rohitnagvenkar/UnmannedVehicleSystems/UVS_images/image016.gif

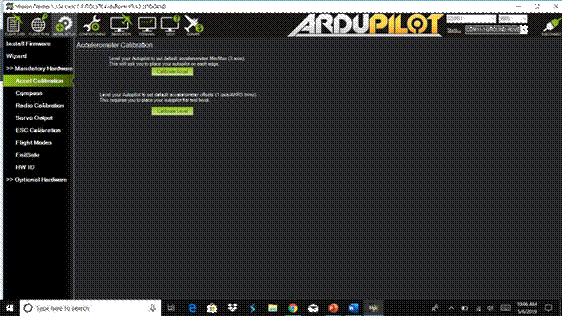
UVS_images/image016.gif
