rohitnagvenkar/UnmannedVehicleSystems/UVS_images/image029.gif

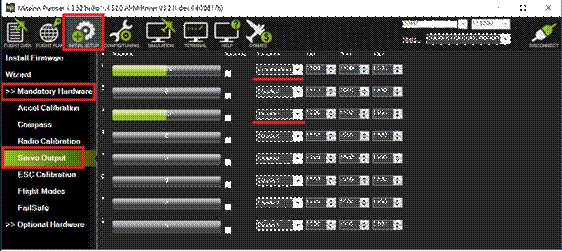
UVS_images/image029.gif
