rohitnagvenkar/UnmannedVehicleSystems/UVS_images/image031.jpg

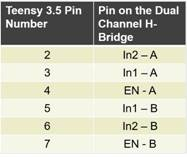
UVS_images/image031.jpg
