rohitnagvenkar/UnmannedVehicleSystems/UVS_images/image048.jpg

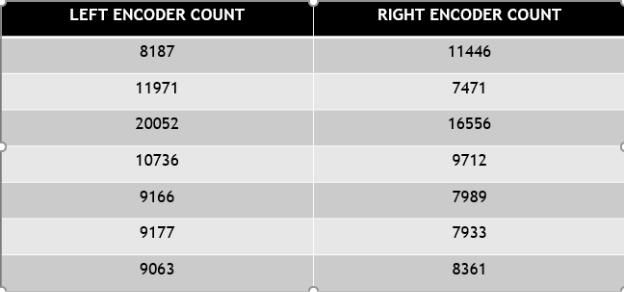
UVS_images/image048.jpg
