rohitnagvenkar/UnmannedVehicleSystems/UVS_images/image049.gif

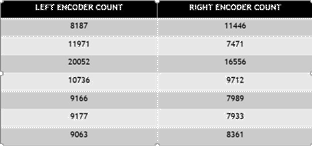
UVS_images/image049.gif
