rohitnagvenkar/UnmannedVehicleSystems/UVS_images/image052.jpg

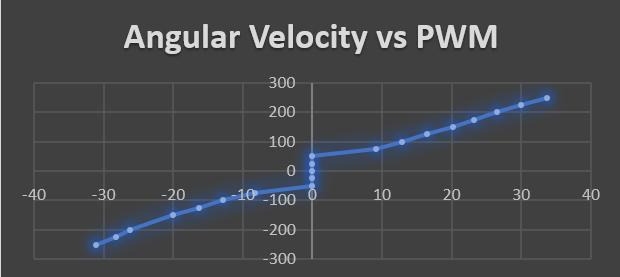
UVS_images/image052.jpg
