rohitnagvenkar/UnmannedVehicleSystems/UVS_images/image072.jpg

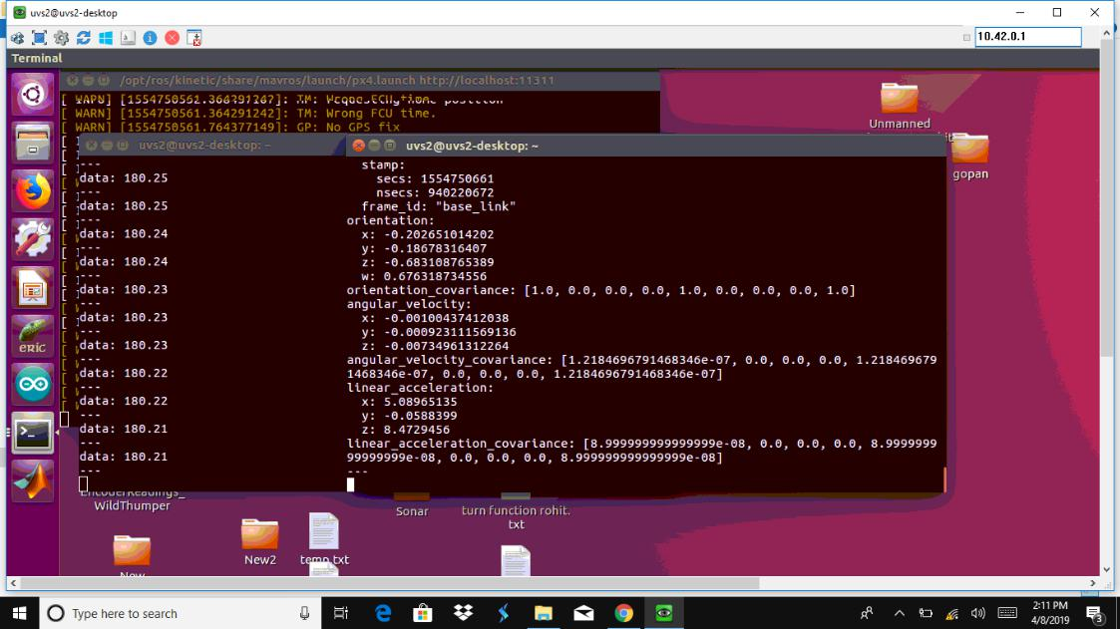
UVS_images/image072.jpg
