rohitnagvenkar/UnmannedVehicleSystems/UVS_images/image074.jpg

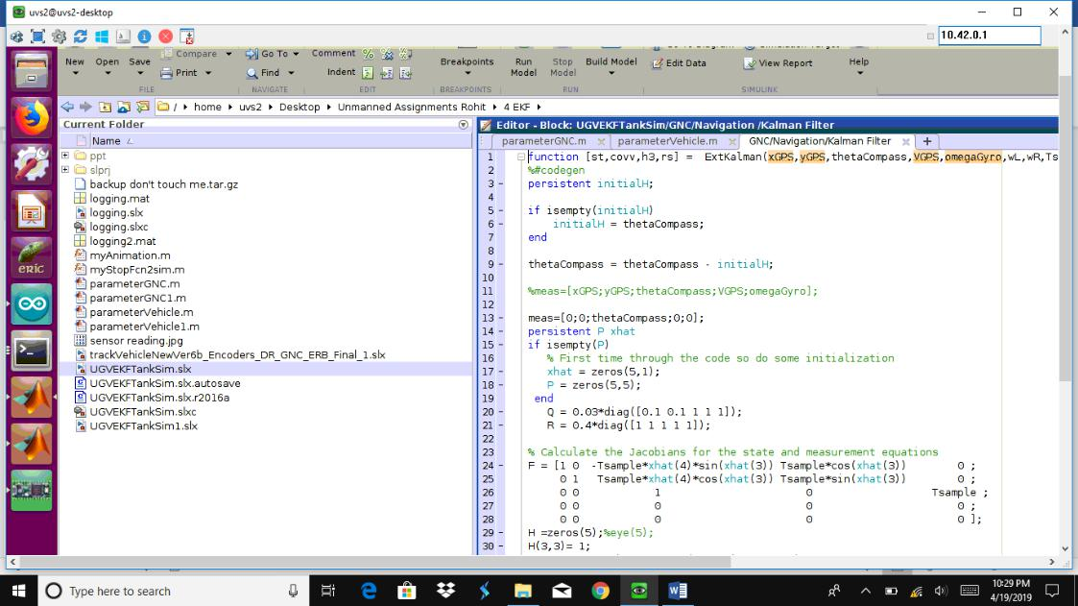
UVS_images/image074.jpg
