rohitnagvenkar/UnmannedVehicleSystems/UVS_images/image082.png

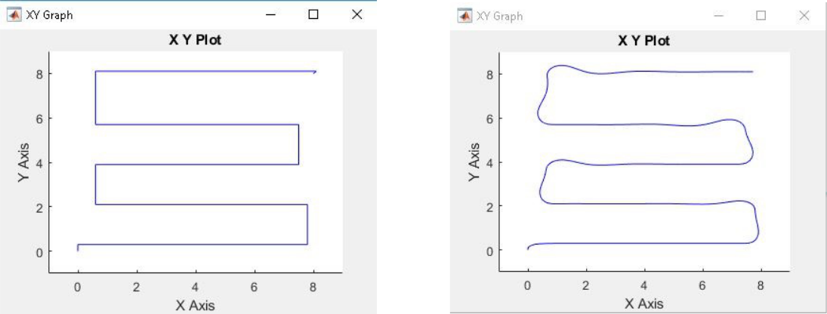
UVS_images/image082.png
