rohitnagvenkar/UnmannedVehicleSystems/UVS_images/image085.jpg

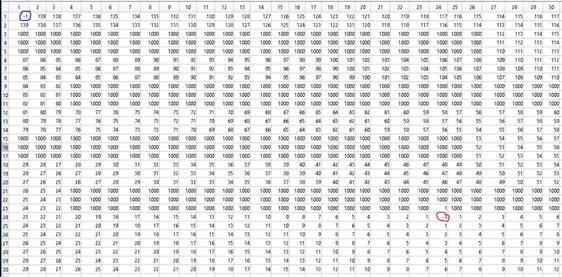
UVS_images/image085.jpg
